axcheb/SaigakTiming/(commit log)

2021-04-15 Receiving data from sensors. Bluetooth, nRF24L01.
2021-05-21 To archive button, new buttons for event fragment
2021-05-22 UI changes. Styles, Buttons, AppBar.
2021-05-25 Sensors fragment and communication with arduino sensors.
2021-05-26 Payload sending fix minSdkVersion 22 gradle-wrapper.properties file
    [MasterNode.ino, SlaveNode.ino]
2021-06-02 Time formatting fix and dependencies update
    [SlaveNode.ino]
2021-06-02 App can run on emulator or device without bluetooth. Bug fixes with handling exceptions on search and sync time.
2021-06-07 Readme: Краткое описание интерфейса
2021-06-11 getters for public imutable fields, getter and checkNotNull for nullable fields, lateinit removed
